Andy1978/needler/doc/usbasp1_3.pdf

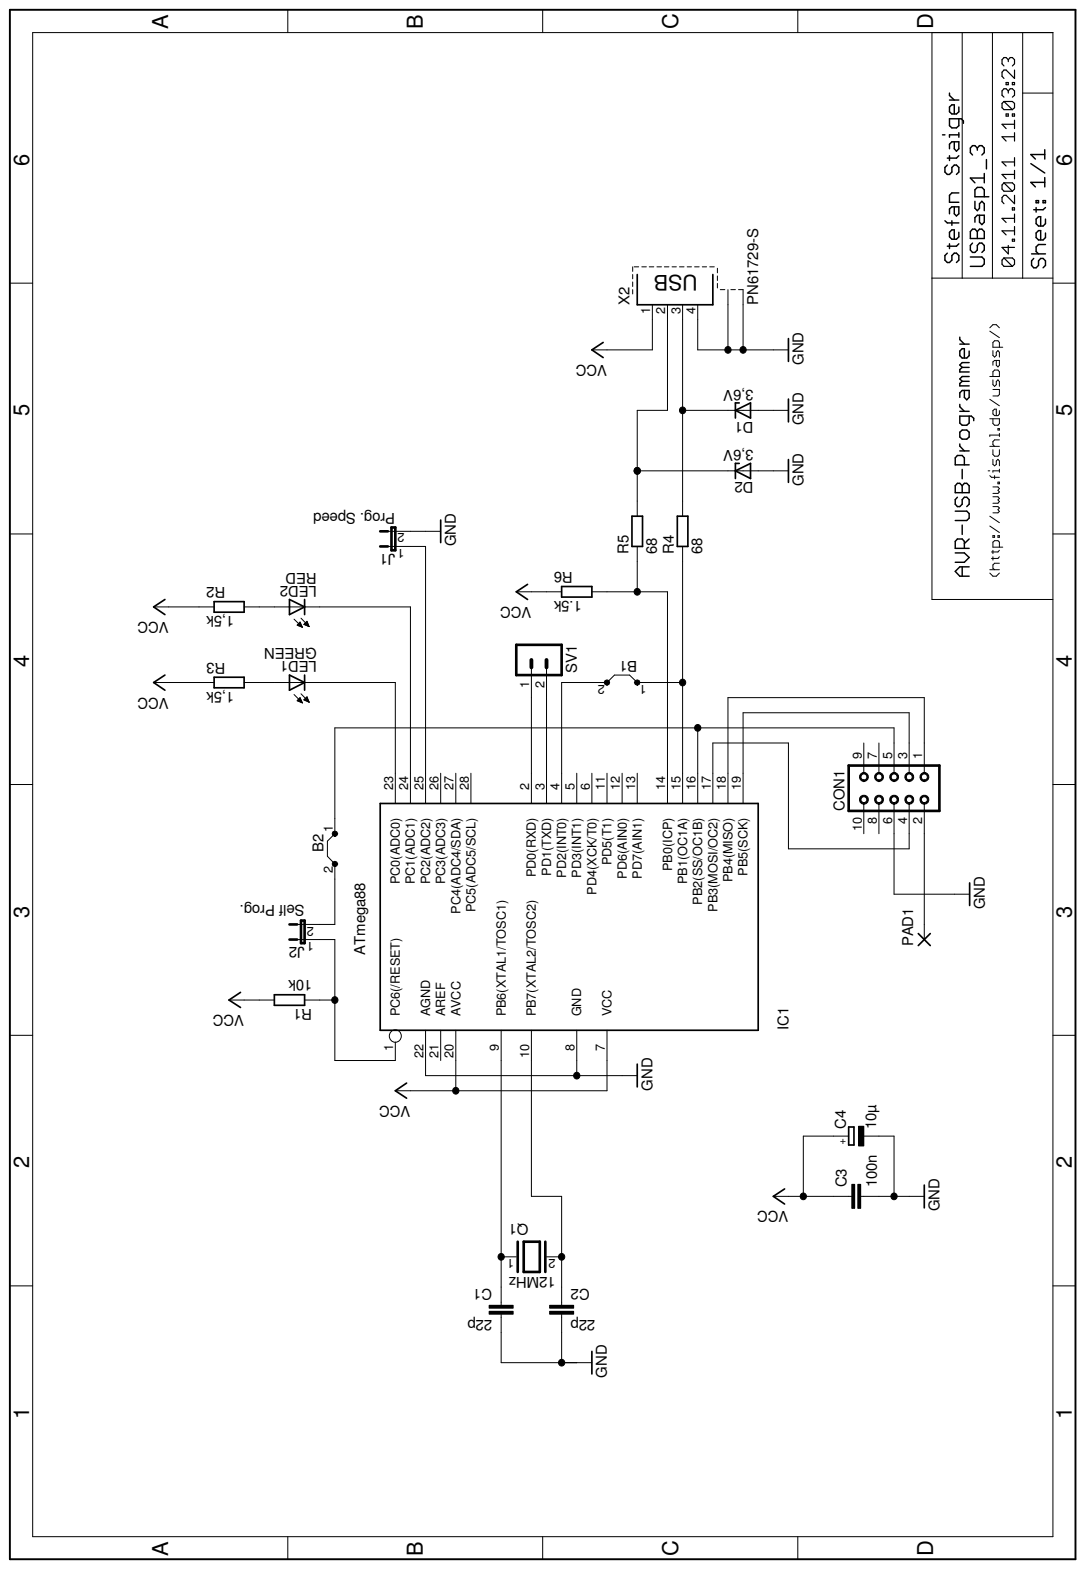
[picture p4: page 1]
ATmega88; GND; GND GND; PN61729-S PB5(SCK) 19; PB7(XTAL2/TOSC2) 10; PB6(XTAL1/TOSC1); VCC; AGND 22 AREF 21; AVCC 20; PD7(AIN1) 13 PD6(AIN0) 12 PD5(T1) 11 PD4(XCK/T0) 6 PD3(INT1); 5 PD2(INT0); 4 PD1(TXD); 3 PD0(RXD); CON1; PAD1

PC5(ADC5/SCL) 28 PC4(ADC4/SDA) 27 PC3(ADC3) 26 PC2(ADC2) 25 PC1(ADC1) 24 PC0(ADC0) 23 PC6(/RESET)

PB4(MISO) 18 PB3(MOSI/OC2) 17 PB2(SS/OC1B) 16 PB1(OC1A) 15 PB0(ICP) 14

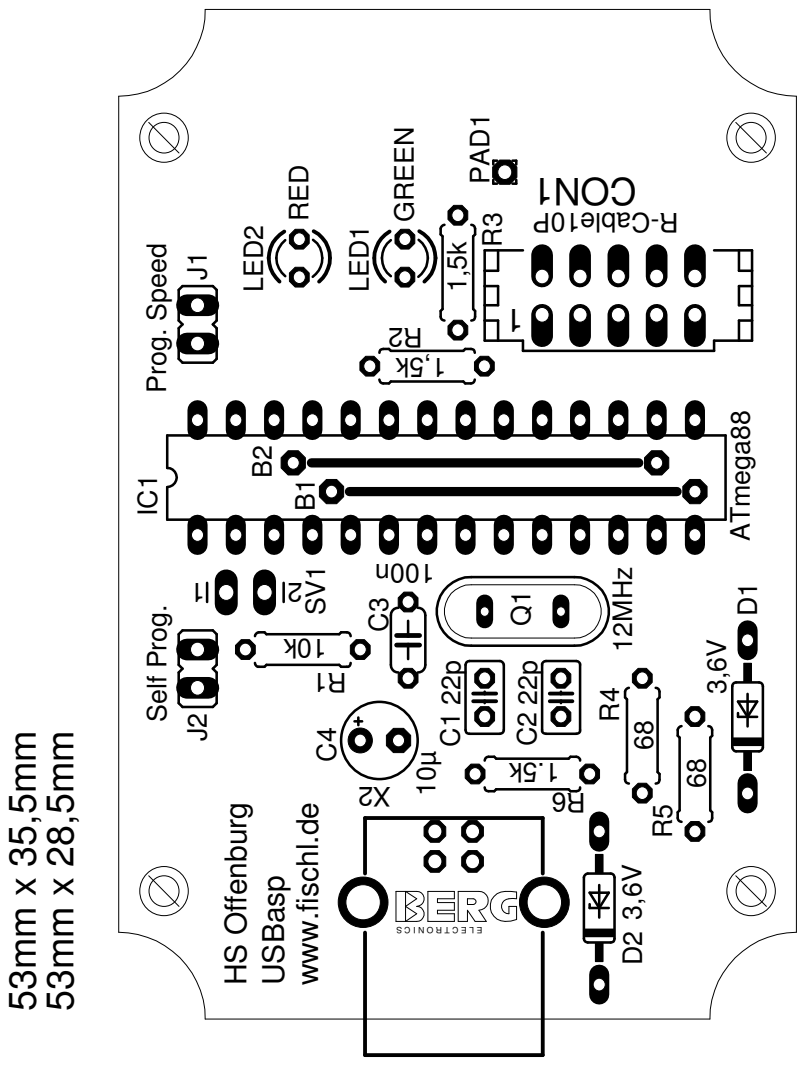
[picture p5: page 2]

Partlist

Menge | Part | Value
2 | C1,C2 | 22p (RM2,5)
1 | C3 | 100n (RM5)
1 | C4 | 10µ (RM2,5)
1 | R1 | 10k
3 | R2,R3,R6 | 1,5k
2 | R4,R5 | 68R
2 | D1,D2 | 3,6V
1 | LED1 | GREEN 3MM
1 | LED2 | RED 3MM
1 | IC1 | MEGA48-P
1 | Q1 | 12MHz
1 | CON1 | LPV 10
1 | X2 | USB B-Stecker
2 | J1,J2 | Stiftleiste 2-Polig
1 | SV1 | Stiftleiste 2-Polig
2 | B1,B2 | Drahtbrücke

### 1 IC Sockel 28-Polig 1 Jumper rot 1 PFL 6 1 Kleingehäuse 2 Schrauben 2,9x6,5

ca. 6cm Silberdraht 0,6mm
ca. 30cm Flachbandleitung 6-polig
