Andy1978/needler/eagle/Needler_Rev_1_00_brd.pdf

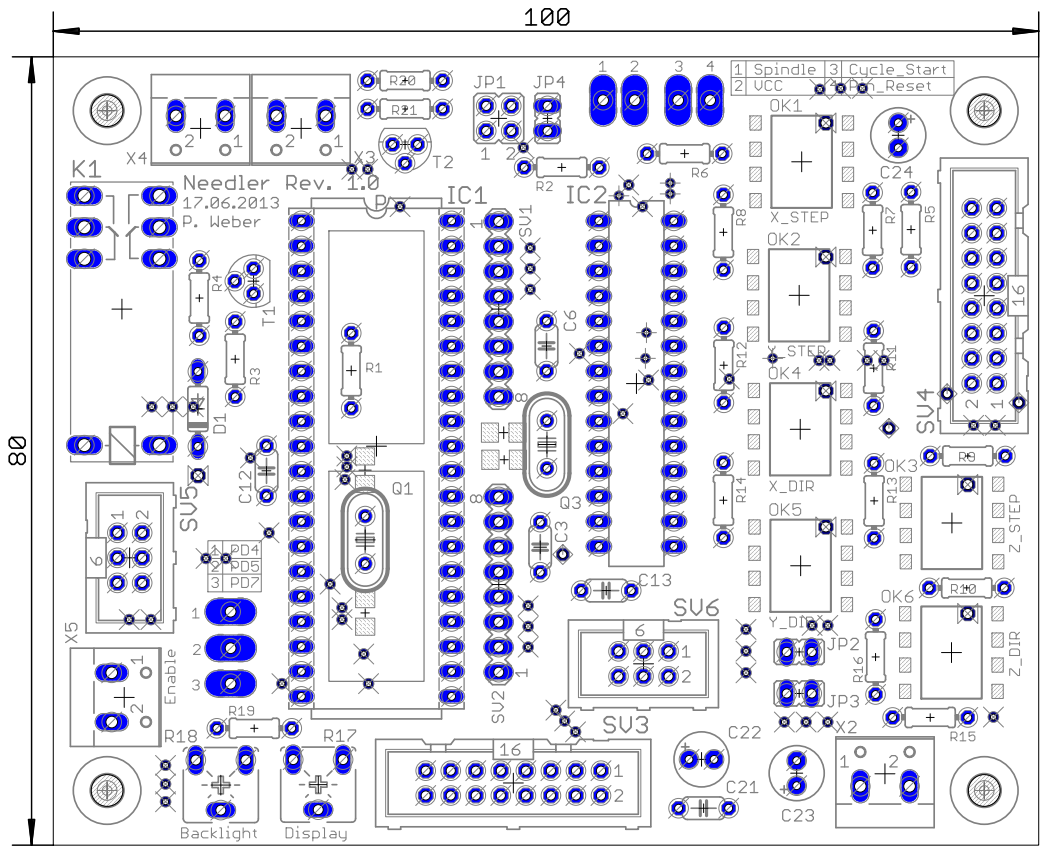
[picture p6: page 1]

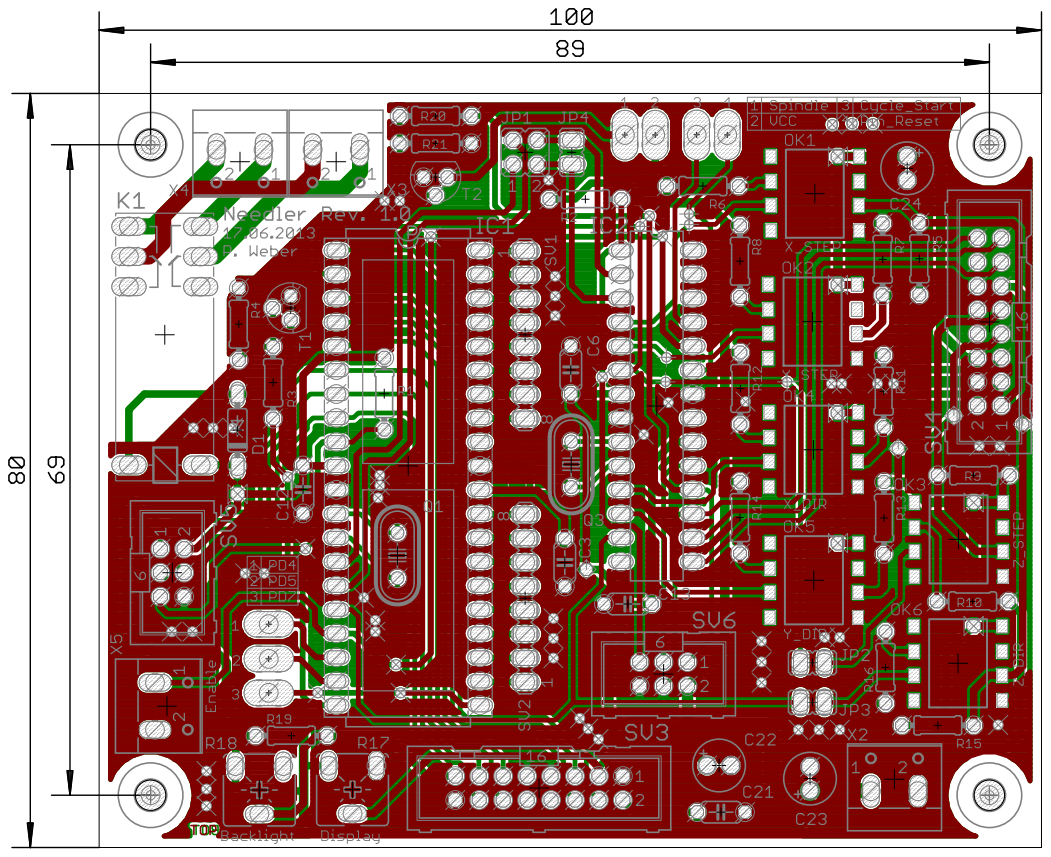
[picture p7: page 2]
