Andy1978/needler/eagle/Needler_Rev_1_00_sch.pdf

A

A

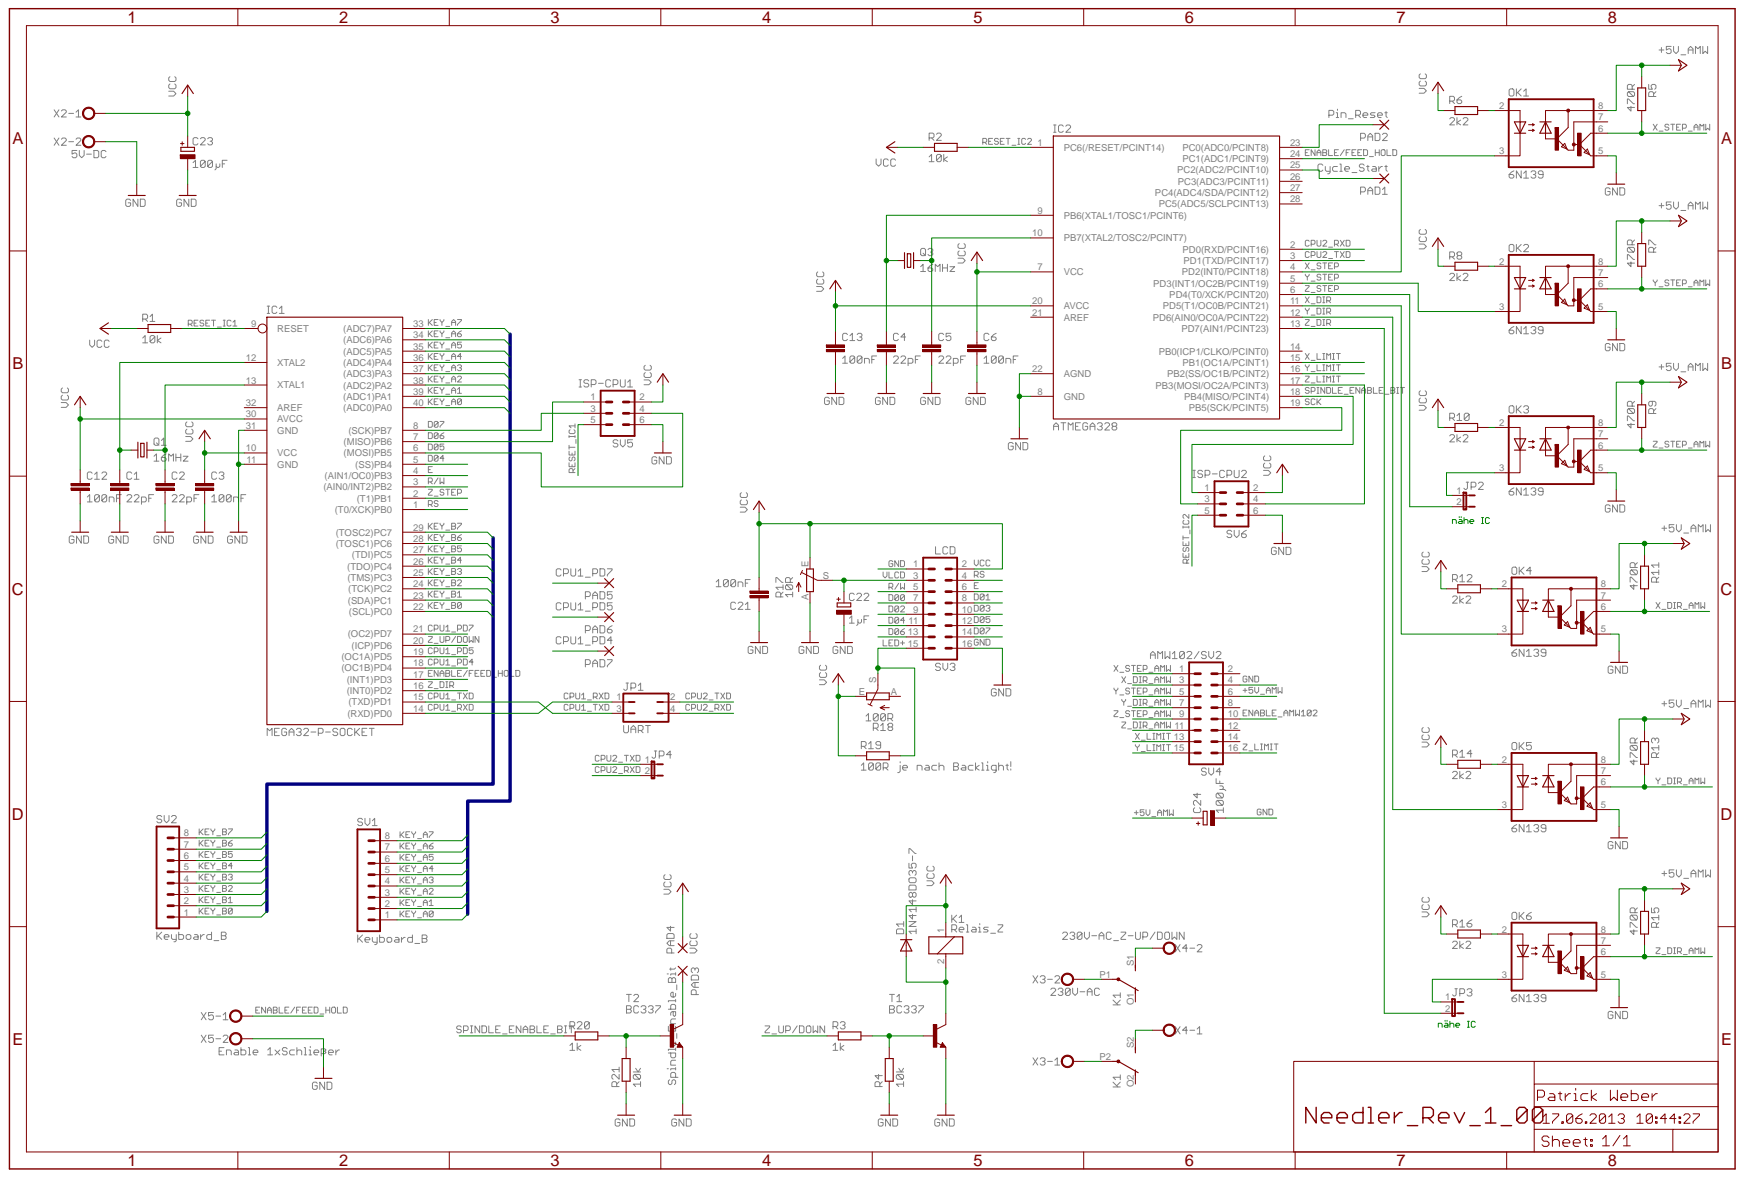
[picture p8: page 1]
PB5(SCK/PCINT5); PB7(XTAL2/TOSC2/PCINT7) 10; PB6(XTAL1/TOSC1/PCINT6) 9; GND 8; VCC 7; AGND 22; AREF 21; AVCC 20; PB4(MISO/PCINT4); 18 PB3(MOSI/OC2A/PCINT3); 17 PB2(SS/OC1B/PCINT2); 16 PB1(OC1A/PCINT1); 15 PB0(ICP1/CLKO/PCINT0); PD7(AIN1/PCINT23); 13 PD6(AIN0/OC0A/PCINT22); 12 PD5(T1/OC0B/PCINT21); 11 PD4(T0/XCK/PCINT20); 6 PD3(INT1/OC2B/PCINT19); 5 PD2(INT0/PCINT18); 4 PD1(TXD/PCINT17); 3 PD0(RXD/PCINT16); PC5(ADC5/SCLPCINT13); 28 PC4(ADC4/SDA/PCINT12); 27 PC3(ADC3/PCINT11)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
