Andy1978/needler/(commit log)

2013-05-30 init schematic
    [needler_grbl.sch]
2013-06-18 schematic and layout Rev_1_00 added
    [Needler_Rev_1_00.brd, Needler_Rev_1_00.sch]
2013-06-21 added matrix keyboard layout
    [8x8_Keyboard.csv]
2013-06-21 needler_grbl.sch: only driver part
    [needler_grbl.sch]
2013-07-05 8x8 Keymatrix sample programm erweitert
2013-07-08 added 2 arcs sample
2013-07-12 GRBL config step/mm berechnet
2013-07-13 debouncing verbessert, grbl kommunikation
2013-07-13 GRBL Readme und Änderungen verschoben
2013-07-13 Pneumatikventil angesteuert über Timer1 und INT0
2013-07-14 Die mega32 firmware grundlegend erweitert, Menu um ESC, Textgröße und Fontname erweitert
2013-07-15 Enable ->Reset Verbindung nachgetragen
    [needler_grbl.sch]
2013-07-15 added GRBL changes patch for needler
